cho45/AVR-Elekey/README.md

消費電流
========

- パワーダウン中: 0.15uA
- キーイング中: 340uA
