cho45/AVR-Elekey/(list of files, drawings)

Other design files:
firmware/wiring.fzz
