cho45/AVR-Elekey/circuit/elekey.brd

## EAGLE design circuit/elekey.brd (2013-11-10)

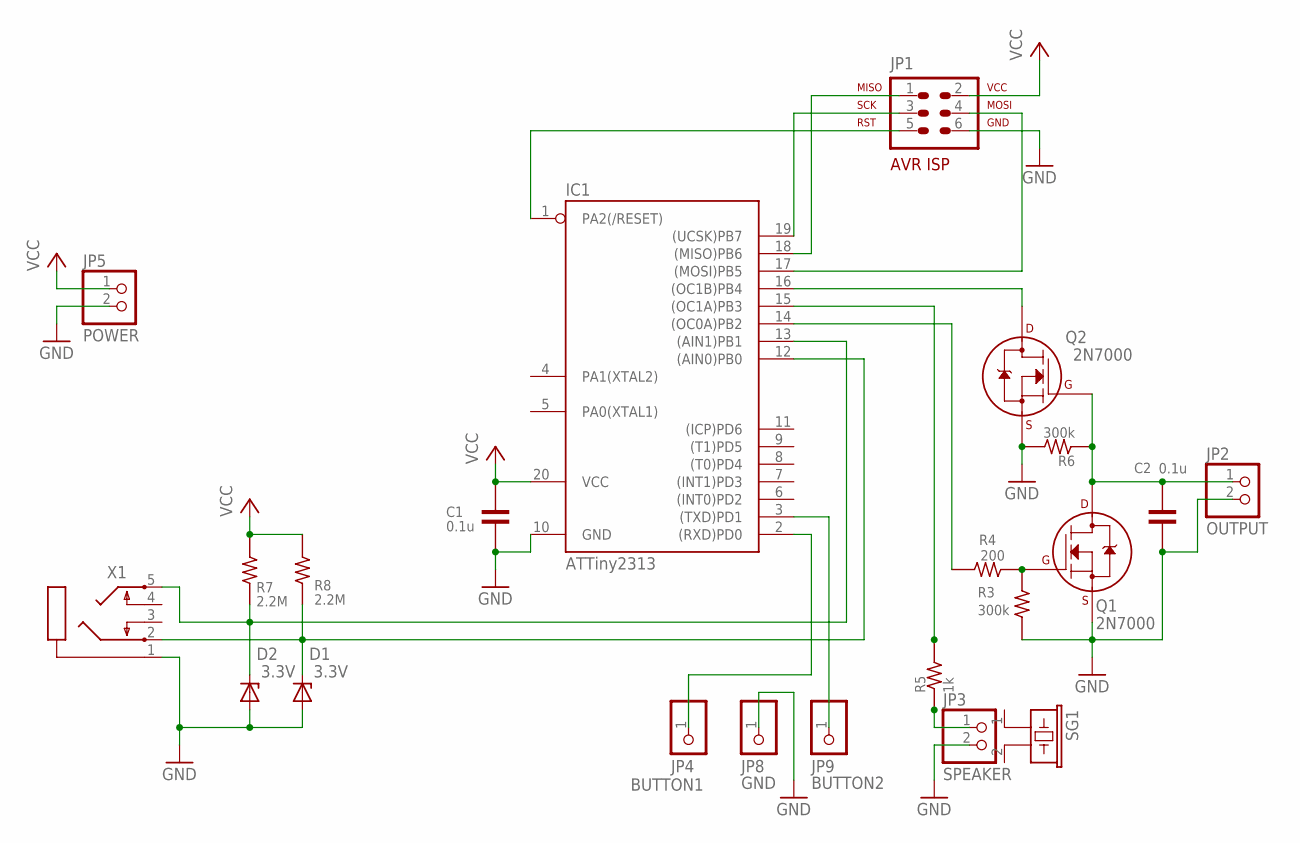
[picture p1: schematic elekey.sch]

Parts:
C1: 0.1u; 50-0302-2.54
C2: 0.1u; 50-0302-5.08
D1, D2: 3.3V; ZDIO-5
IC1: ATTiny2313; DIL20
JP1: AVR-ISP-6VERT; AVR-ISP-6
JP2: OUTPUT; 1X02
JP3: SPEAKER; 1X02
JP4: BUTTON1; 1X01
JP5: POWER; 1X02
JP8: GND; 1X01
JP9: BUTTON2; 1X01
Q1, Q2: 2N7000; TO-92
R3: 300k; 1/4W-2.54V
R4: 200; 1/4W-7.62H
R5: 1k; 1/4W-5.08V
R6: 300k; 1/4W-5.08V
R7: 2.2M; 1/4W-10.16H
R8: 2.2M; 1/4W-7.62H
SG1: EFBRD24C411
X1: PG203J

Connections:
GND: C1.PAD2 (2), C2.PAD2 (2), D1.A, D2.A, IC1.10 (GND), JP1.6, JP2.2, JP3.2, JP5.2, JP8.1, Q1.1 (S), Q2.1 (S), R3.PAD2 (2), R6.PAD2 (2), X1.1
unnamed: D1.C, IC1.12 ((AIN0)PB0), R8.PAD1 (1), X1.2
unnamed: D2.C, IC1.13 ((AIN1)PB1), R7.PAD1 (1), X1.5
unnamed: IC1.18 ((MISO)PB6), JP1.1
unnamed: IC1.1 (PA2(/RESET)), JP1.5
unnamed: IC1.19 ((UCSK)PB7), JP1.3
unnamed: IC1.17 ((MOSI)PB5), JP1.4
unnamed: IC1.16 ((OC1B)PB4), Q2.3 (D)
unnamed: C2.PAD1 (1), JP2.1, Q1.3 (D), Q2.2 (G), R6.PAD1 (1)
unnamed: Q1.2 (G), R3.PAD1 (1), R4.PAD1 (1)
unnamed: IC1.15 ((OC1A)PB3), R5.PAD2 (2)
unnamed: IC1.14 ((OC0A)PB2), R4.PAD2 (2)
unnamed: JP3.1, R5.PAD1 (1)
unnamed: IC1.2 ((RXD)PD0), JP4.1
unnamed: IC1.3 ((TXD)PD1), JP9.1
VCC: C1.PAD1 (1), IC1.20 (VCC), JP1.2, JP5.1, R7.PAD2 (2), R8.PAD2 (2)

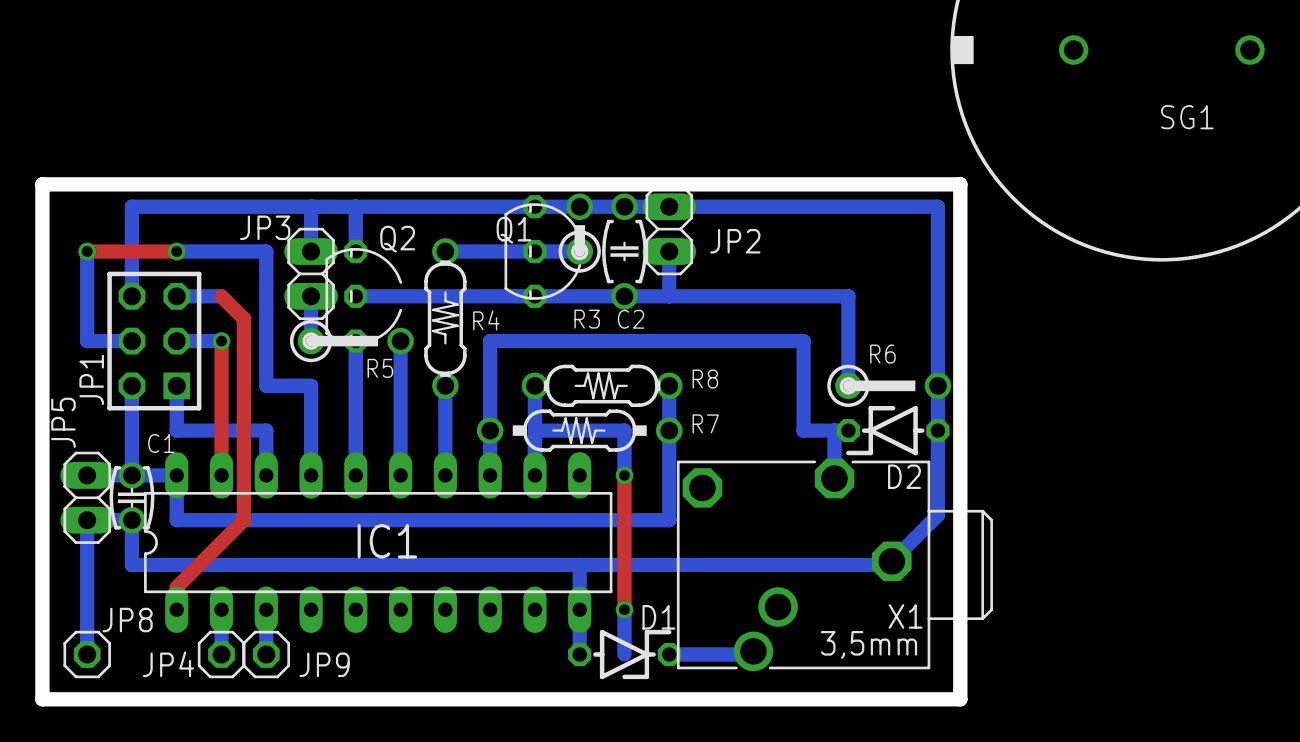
[picture p2: board elekey.brd from above]

Board: 2 copper layers, 52.1 x 29.2 mm, 22 parts (0 on the bottom side), 16 nets.
