cho45/AVR-Elekey/firmware/main.c

#include <avr/io.h>
#include <avr/interrupt.h>
#include <util/delay.h>
#include <avr/sleep.h>

#define INPUT_DASH PB0
#define INPUT_DOT PB1
#define OUTPUT_KEY PB2
#define SIDE_TONE_SWITCH PB4
#define SPEED_UP_KEY PD0
#define SPEED_DOWN_KEY PD1

#define SIDE_TONE_FREQ 600
#define SIDE_TONE_PIN_A OC1A
#define SIDE_TONE_PIN_B OC1B

#define INHIBIT_RATE 0.3
#define INHIBIT_TIME(speed) ((uint16_t)(1200 * INHIBIT_RATE) / speed)
#define INHIBIT_AFTER(speed) ((uint16_t)(1200 * (1 - INHIBIT_RATE)) / speed)

#define clear_bit(v, bit) v &= ~(1 << bit)
#define set_bit(v, bit)   v |=  (1 << bit)

#define CLOCK_DEVIDE 1
#define TIMER_INTERVAL (1.0 / (F_CPU / CLOCK_DEVIDE / 256) * 1000)
#define INTERVAL_UNIT_IN_MS (uint16_t)(1.0 / TIMER_INTERVAL + 0.5)
#define DURATION(msec) (uint16_t)(msec * INTERVAL_UNIT_IN_MS)

uint8_t dot_keying, dash_keying;
uint8_t speed;
uint8_t unit;

uint16_t keypressing[8];
uint8_t keydown[8], keyup[8];

uint16_t idle;
uint16_t delay;
uint16_t timer;

// Max = 65535 / INTERVAL_UNIT = 16383msec
void delay_ms(uint16_t t) {
	uint16_t end;
	cli();
	delay = 0;
	end = delay + DURATION(t);
	sei();
	while (delay <= end) {
		set_sleep_mode(SLEEP_MODE_IDLE);
		sleep_mode();
	}
}

static inline void SET_TONE(uint16_t freq) {
	if (freq) {
		TCCR1A = 0b01000001;
		OCR1A = (F_CPU / CLOCK_DEVIDE) / freq / 4;
		ICR1 = OCR1A / 2;
	} else {
		TCCR1A = 0b00000001;
	};
}

static inline void start_beep() { SET_TONE(SIDE_TONE_FREQ); }
static inline void stop_beep() { SET_TONE(0); }

static inline void start_output() {
	set_bit(PORTB, OUTPUT_KEY);
	if (bit_is_set(PINB, SIDE_TONE_SWITCH)) {
		start_beep();
	}
}

static inline void stop_output() {
	clear_bit(PORTB, OUTPUT_KEY);
	if (bit_is_set(PINB, SIDE_TONE_SWITCH)) {
		stop_beep();
	}
}

static inline void update_button_states() {
	static char prev;
	static char curr;
	static uint16_t last;
	uint8_t i;

	if (timer < last) last = timer;
	if (timer < (last + DURATION(10))) return;
	last = timer;

	curr = PIND;
	// DDRD は 7bit しかない (上位1bit不定)
	for (i = 0; i < 7; i++) {
		if (bit_is_set(DDRD, (i))) continue; // skip output port
		keydown[i] = keyup[i] = 0;

		if ( (curr ^ prev) & _BV(i)) {
			if (!keypressing[i] && bit_is_clear(curr, i)) {
				keydown[i] = 1;
			} else
			if (keypressing[i] > 0 && bit_is_set(curr, i)) {
				keyup[i] = 1;
			}
		}

		if (bit_is_clear(curr, i)) {
			keypressing[i]++;
			idle = 0;
		} else {
			keypressing[i] = 0;
		}
	}
	prev = curr;
}

static inline void clear_button_states() {
	uint8_t i;
	for (i = 0; i < 8; i++){
		keypressing[i] = 0;
		keyup[i] = 0;
		keydown[i] = 0;
	}
}


void _play(uint8_t number) {
	static uint32_t numbers[] = {
		0b1110111011101110111,
		0b10111011101110111,
		0b101011101110111,
		0b1010101110111,
		0b10101010111,
		0b101010101,
		0b11101010101,
		0b1110111010101,
		0b111011101110101,
		0b11101110111011101,
	};

	uint32_t n = numbers[number];
	uint8_t i = 0;

	for (i = 0; i < 32; i++) {
		if (n >> (31 - i) & 1) {
			i -= 1;
			break;
		}
	}

	for (; i < 32; i++) {
		if (n >> (31 - i) & 1) {
			start_beep();
			delay_ms(unit);
		} else {
			stop_beep();
			delay_ms(unit);
		}
	}
	stop_beep();
}

void play(uint8_t num) {
	_play(num / 10);
	delay_ms(unit * 2);
	_play(num % 10);
}


/**
 * メインループはビジーループに入ったりするので、割り込みでボタン状態を見る
 *
 */
ISR(TIMER0_OVF_vect) {
	delay++;
	timer++;
	idle++;

	if (bit_is_clear(PINB, INPUT_DOT)) {
		dot_keying = 1;
	}

	if (bit_is_clear(PINB, INPUT_DASH)) {
		dash_keying = 1;
	}
}

/**
 * キーの入力レベルが変わったとき (押したとき・離したとき) に割込みがかかる
 *
 */
ISR(PCINT_vect) {
	idle = 0;
}

void play_ok() {
	start_beep();
	delay_ms(unit * 3);
	stop_beep();
	delay_ms(unit);
	start_beep();
	delay_ms(unit);
	stop_beep();
	delay_ms(unit);
	start_beep();
	delay_ms(unit * 3);
	stop_beep();
	delay_ms(unit);
}

void play_beep() {
	SET_TONE(800);
	delay_ms(100);
	SET_TONE(1200);
	delay_ms(150);
	SET_TONE(0);
}

void setup_io() {
	/**
	 * Data Direction Register: 0=input, 1=output
	 * 必要なポートだけインプットポートにする。
	 */
	DDRA  = 0b11111111;
	DDRB  = 0b11101100;
	DDRD  = 0b11111100;

	/**
	 * Pull-up puddle pin
	 * 入力ピンをオープンにすると不安定になるので、プルアップ(VCCに繋げる)して
	 * 電位を安定させる。スイッチは PIN <-> SWITCH <-> GND となり、押したときに
	 * GND すなわち0になる
	 */
	PORTB = 0b00010000;
	PORTD = 0b00000011;

	/**
	 * Timer0 の分周設定
	 * TCCR0B 下位3bit
	 *  000 -> 停止
	 *  001 -> 分周なし
	 *  010 -> 8分周
	 *  011 -> 64分周
	 *  100 -> 256分周
	 *  101 -> 1024分周
	 */
	TCCR0A = 0b00000000;
	TCCR0B = 0b00000001;

	/**
	 * Timer0 のオーバーフロー割り込みを有効化
	 */
	TIMSK = 0b00000010;
	//set_bit(TIMSK, TOIE0);

	/**
	 * Timer1 の設定
	 * 位相・周波数 PWM
	 * 0 から top まで登りカウントして、途中 compare を超えると出力がHになり、
	 * 今度は 0 まで下りカウントして途中 compare を下まわると出力がLになる。
	 * 今回はただの圧電スピーカー駆動なので duty 比 50% (compare が常に 1/2) にしてる
	 * */
	// WGM13=1, WGM12=0, WGM11=0, WGM10=1
	TCCR1A = 0b01000001;
	TCCR1B = 0b00010001;

	/**
	 * キー割り込み
	 * スリープ復帰用
	 */ 
	GIMSK = 0b00100000;
	PCMSK = (1<<PCINT0)|(1<<PCINT1);

	/**
	 * 割り込み有効化
	 */
	sei();

}

int main(void) {
	uint8_t enable = 1;

	setup_io();

	speed = 20;
	unit = 1200 / speed;
	timer = 0;
	delay = 0;
	idle = 0;

	clear_button_states();

	/**
	 * ini message
	 */
	play_beep();

	for (;;) {
		update_button_states();

		if (keypressing[SPEED_UP_KEY] > 200 && keypressing[SPEED_DOWN_KEY] > 200) {
			play_ok();
			enable = !enable;
			delay_ms(500);
			clear_button_states();
		} else
		if (
			(keypressing[SPEED_UP_KEY] > 200 && !keypressing[SPEED_DOWN_KEY]) || 
			(keypressing[SPEED_DOWN_KEY] > 200 && !keypressing[SPEED_UP_KEY])
		) {
			play(speed);
			delay_ms(500);
			clear_button_states();
		}


		if (keyup[SPEED_UP_KEY]) {
			if (speed < 40) {
				speed++;
				unit = (int)(1200 / speed);
				play_beep();
				delay_ms(200);
			}
		}

		if (keyup[SPEED_DOWN_KEY]) {
			if (1 < speed) {
				speed--;
				unit = (int)(1200 / speed);
				play_beep();
				delay_ms(200);
			}
		};

		if (enable) {
			if (dot_keying) {
				start_output();
				delay_ms(unit);
				stop_output();
				delay_ms(INHIBIT_TIME(speed));
				dot_keying = 0;
				delay_ms(INHIBIT_AFTER(speed));
				idle = 0;
			}

			if (dash_keying) {
				start_output();
				delay_ms(unit * 3);
				stop_output();
				delay_ms(INHIBIT_TIME(speed));
				dash_keying = 0;
				delay_ms(INHIBIT_AFTER(speed));
				idle = 0;
			}
		} else {
			while (bit_is_clear(PINB, INPUT_DOT) || bit_is_clear(PINB, INPUT_DASH)) {
				start_output();
				_delay_ms(10);
			}
			stop_output();
			dot_keying = dash_keying = 0;
		}

		// 10000msec 経ったらパワーダウン
		if (idle > DURATION(10000)) {
			set_sleep_mode(SLEEP_MODE_PWR_DOWN);
			sleep_mode();
			timer = 0;
		} else {
			set_sleep_mode(SLEEP_MODE_IDLE);
			sleep_mode();
		}
	}
	return 0;
}
