cho45/AVR-Elekey/(commit log)

2013-10-12 省電力化
2013-10-12 macro を減らしとく
2013-10-12 inline function よくわからなすぎるのでやめた
2013-10-13 同時押しとかを実装。。http://www.adafruit.com/blog/2009/10/20/example-code-for-multi-button-checker-with-debouncing/
2013-10-13 idle にならない
2013-10-13 1MHz クロックバージョン
2013-10-13 8MHz、パワーダウンモードからの復帰が遅すぎてつらい
2013-10-14 Update fuse
2013-10-15 符号スピードが遅すぎるのでもどす
2013-10-17 消費電流減らし
2013-10-17 ISP をやめれば電流流れなくなるのでやめた
2013-10-18 リグ側に電圧がかからないように FET でスイッチするように
2013-10-22 inhibit 精度向上
2013-11-10 コメントがおかしい
    [elekey.brd, elekey.sch]
2013-11-13 tone 周波数がおかしい…
